KV-33-PRO/immo/src/costmap_converter/README.md

costmap_converter ROS Package
=============================

A ros package that includes plugins and nodes to convert occupied costmap2d cells to primitive types

Build status of the *master* branch:
- ROS Buildfarm Kinetic: Kinetic Build Status (http://build.ros.org/job/Kdev__costmap_converter__ubuntu_xenial_amd64/)
- ROS Buildfarm Indigo: Indigo Build Status (http://build.ros.org/job/Idev__costmap_converter__ubuntu_trusty_amd64/)

### Contributors

- Christoph Rösmann
- Franz Albers (*CostmapToDynamicObstacles* plugin)
- Otniel Rinaldo

### License

The *costmap_converter* package is licensed under the BSD license.
It depends on other ROS packages, which are listed in the package.xml. They are also BSD licensed.

Some third-party dependencies are included that are licensed under different terms:
 - *MultitargetTracker*, GNU GPLv3, https://github.com/Smorodov/Multitarget-tracker
   (partially required for the *CostmapToDynamicObstacles* plugin)

All packages included are distributed in the hope that they will be useful, but WITHOUT ANY WARRANTY; without even the implied warranty of MERCHANTABILITY or FITNESS FOR A PARTICULAR PURPOSE. See the licenses for more details.
