KV-33-PRO/immo/hardware/misc/README.txt

Дополнительная информация:
http://savageelectronics.blogspot.com/2011/08/actualizacion-biblioteca-dynamixel.html
http://hobbytech.com.ua/dynamixel-ax-12a-%D0%B8-arduino-%D0%BA%D0%B0%D0%BA-%D0%B8%D1%81%D0%BF%D0%BE%D0%BB%D1%8C%D0%B7%D0%BE%D0%B2%D0%B0%D1%82%D1%8C-%D0%BF%D0%BE%D1%8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
https://m.blog.naver.com/chandong83/221009668897
