KV-33-PRO/immo/hardware/src/modules_for_ROS/LedControl/README.txt

**********************************   README FILE   ***************************************

Contact: Kvantorium33

Version: Led_control library for ROS 01/01/2019

 Led_control Version 1.0.0

Requeriments:

Arduino IDE Version 1.0
Wiring IDE 0100

Installation:

Copy the files to your IDE libraries folder.

examples:

In the Program:
Copy "Led_control" folder to Arduino/Contents/Resources/Java/libraries. 

or

In the SketchBook:
Copy "Led_control" folder to Arduino/libraries.

ChangeLog:

 01/01/2019 - Create library.

 TODO:

******************************************************************************************
