KV-33-PRO/immo/hardware/misc/Battery_function.xlsx

analog | V
0 | 0 | 0
54 | 0.5 | 54
110 | 1 | 56
167 | 1.5 | 57
223 | 2 | 56
280 | 2.5 | 57
336 | 3 | 56
392 | 3.5 | 56
449 | 4 | 57
505 | 4.5 | 56
562 | 5 | 57
619 | 5.5 | 57
675 | 6 | 56
732 | 6.5 | 57
788 | 7 | 56
845 | 7.5 | 57
901 | 8 | 56
958 | 8.5 | 57
1014 | 9 | 56
1071 | 9.5 | 57
1129 | 10 | 58
1185 | 10.5 | 56
1242 | 11 | 57
1298 | 11.5 | 56
1356 | 12 | 58
1412 | 12.5 | 56
1468 | 13 | 56
1525 | 13.5 | 57
1583 | 14 | 58
1640 | 14.5 | 57
1697 | 15 | 57
26216 | 232.5 | 1697
873.8666667 | 7.75 | 56.56666667 | 113.1333333
 | 112.7569892
