KV-33-PRO/immo/src/graph_route/maps/map.png

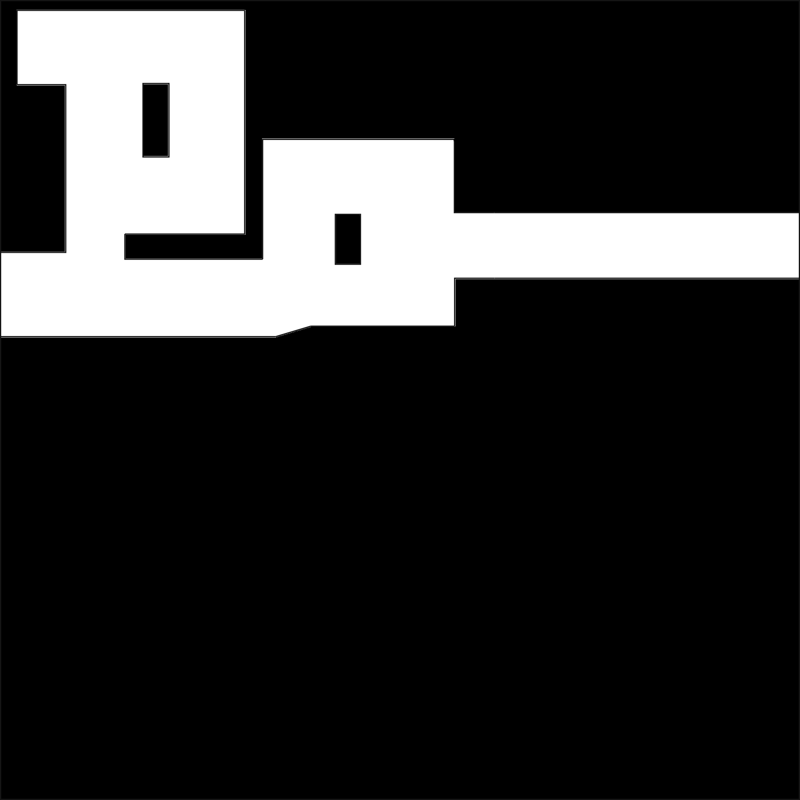
src/graph_route/maps/map.png
