KV-33-PRO/immo/src/graph_route/maps/profest.png

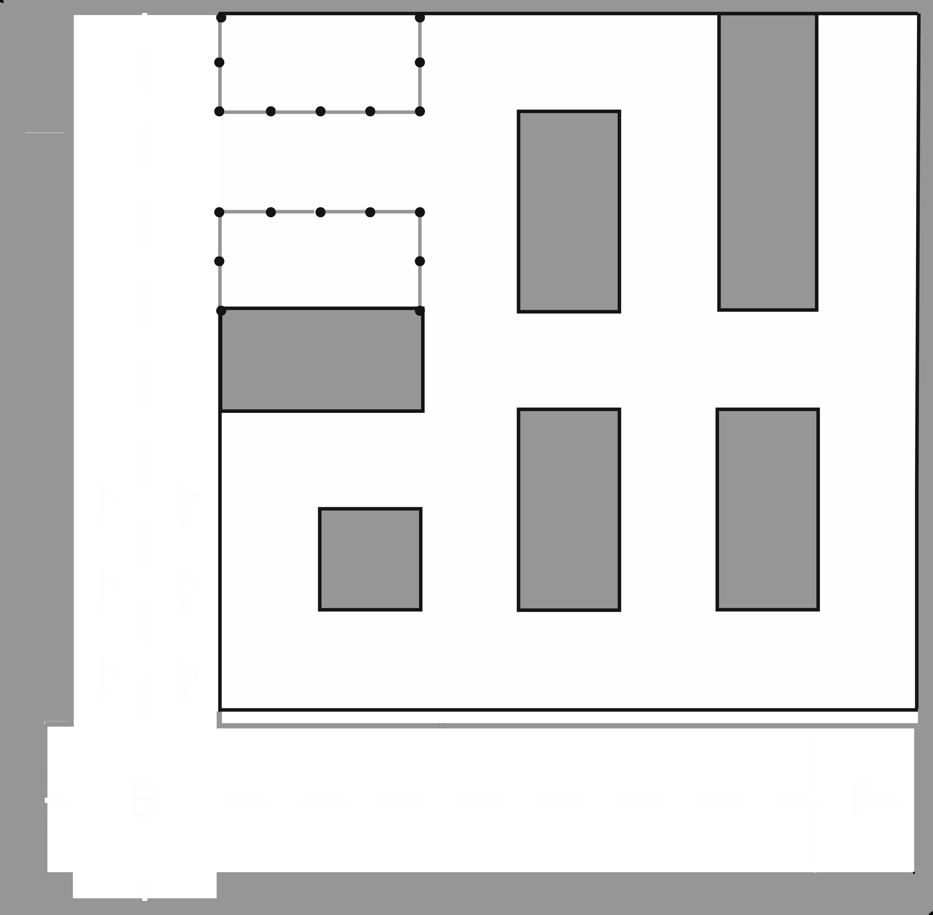
src/graph_route/maps/profest.png
