KV-33-PRO/immo/design/immo_design_project/Dynamixel AX-12/AX-12A.STEP

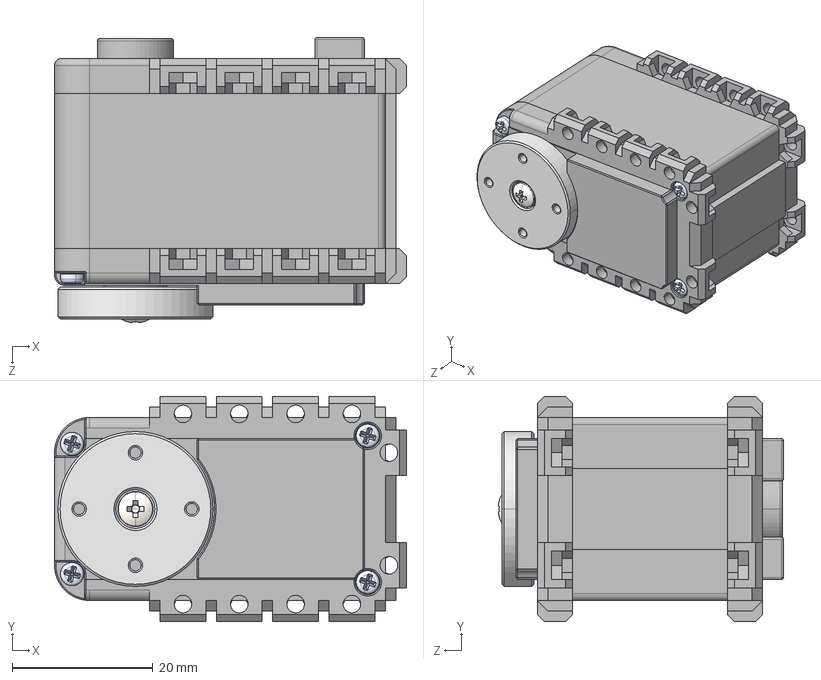
[picture p32: CAD file, 2018-12-13]
design/immo_design_project/Dynamixel AX-12/AX-12A.STEP
50.0 x 32.0 x 40.5 mm
AX-12A-01
AX-12A-02
AX-12A-03
AX-12A-04
SetScrew x 4
pan head cross recess screw_iso_ISO 7045 - M2.5 x 8 - Z --- 8C
