KV-33-PRO/immo/design/immo_design_project/В производство/06-01-Платформа для лидара.dxf

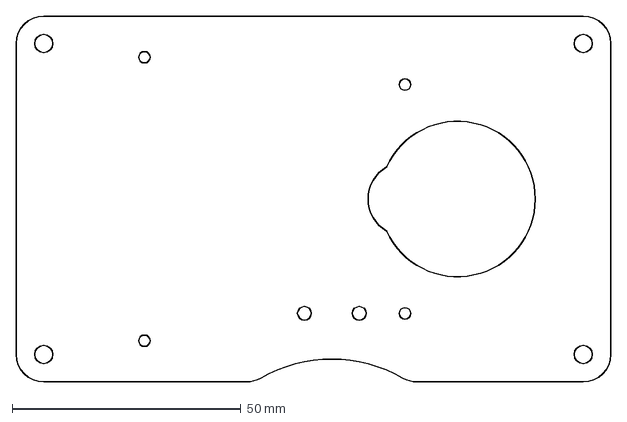
[picture p33: CAD file, 2018-12-15]
design/immo_design_project/В производство/06-01-Платформа для лидара.dxf
130.0 x 80.0 mm
