KV-33-PRO/immo/design/immo_design_project/В производство/04-01-Качалка.stl

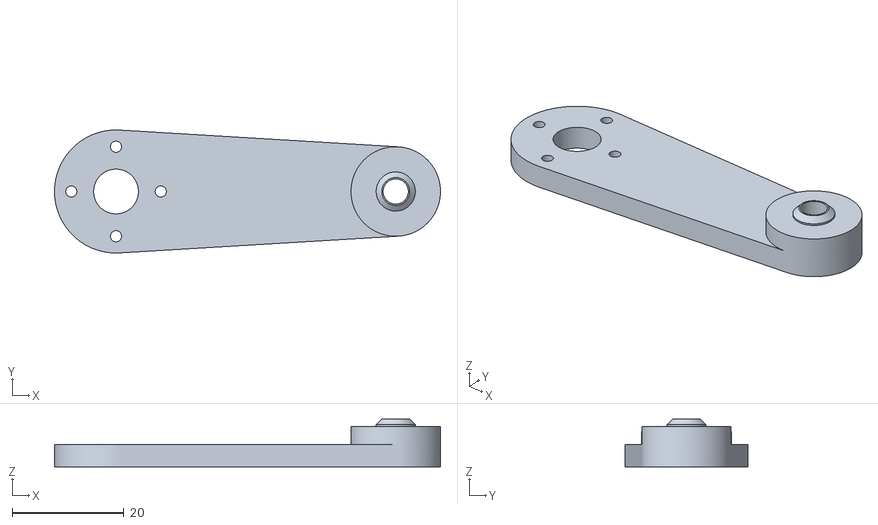
[picture p34: CAD file, 2018-12-13]
design/immo_design_project/В производство/04-01-Качалка.stl
69.0 x 22.0 x 8.55
