KV-33-PRO/immo/design/immo_design_project/В производство/05-01-Кронштейн низ защита.stl

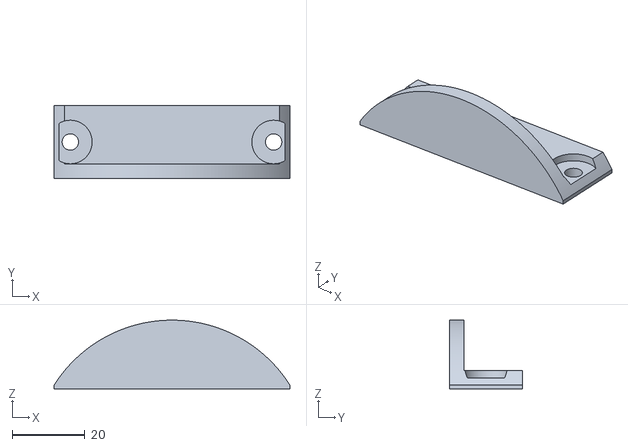
[picture p35: CAD file, 2018-12-13]
design/immo_design_project/В производство/05-01-Кронштейн низ защита.stl
65.0 x 20.0 x 18.9
