KV-33-PRO/immo/design/immo_design_project/В производство/05-01-Кронштейн верх.stl

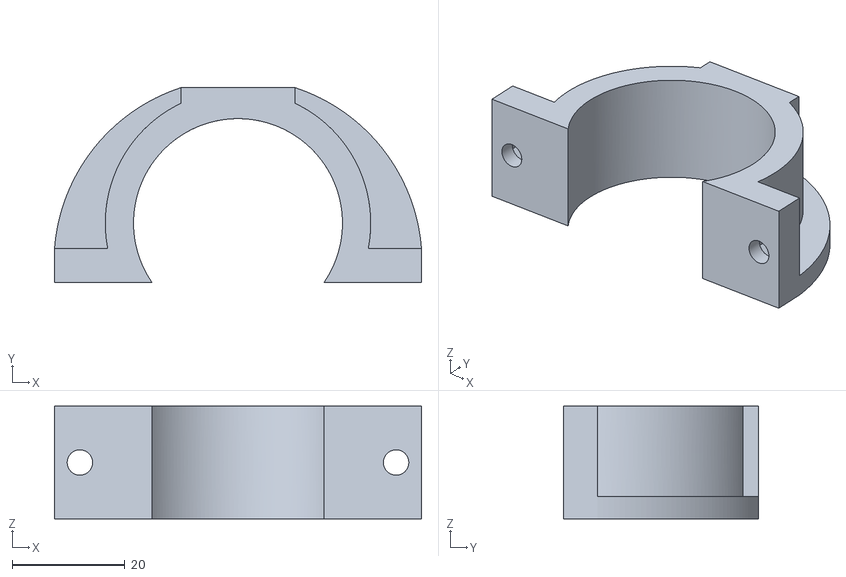
[picture p36: CAD file, 2018-12-13]
design/immo_design_project/В производство/05-01-Кронштейн верх.stl
65.0 x 34.5 x 20.0
