KV-33-PRO/immo/design/immo_design_project/В производство/04-08-Опора.stl

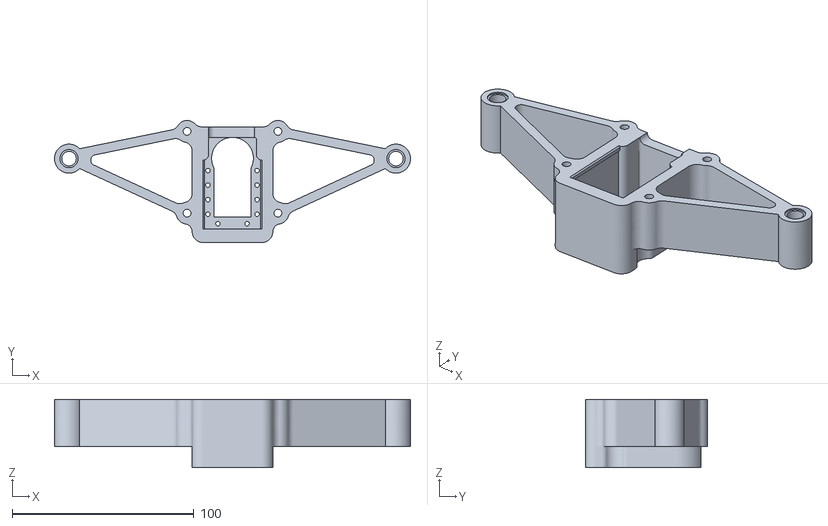
[picture p37: CAD file, 2018-12-13]
design/immo_design_project/В производство/04-08-Опора.stl
196.0 x 67.2 x 37.7
