KV-33-PRO/immo/design/immo_design_project/В производство/Ответная часть энкодера(колесо).stl

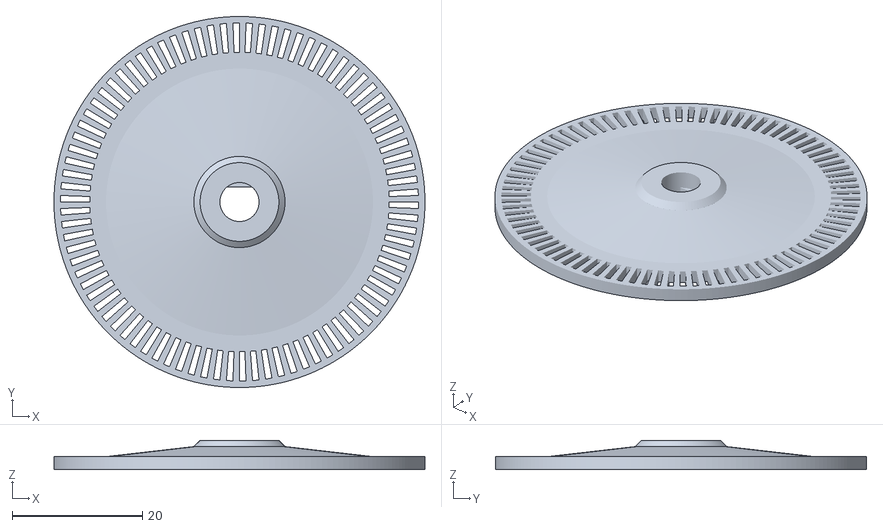
[picture p38: CAD file, 2018-12-13]
design/immo_design_project/В производство/Ответная часть энкодера(колесо).stl
57.0 x 57.0 x 4.50
