KV-33-PRO/immo/(list of files, cad)

Other CAD files:
design/immo_design_project/00-00-Сборка.iam
design/immo_design_project/00-01-Платформа.ipt
design/immo_design_project/01-00-Колесо.iam
design/immo_design_project/01-01-Шина.ipt
design/immo_design_project/01-02-Диск.ipt
design/immo_design_project/02-00-Двигатель.ipt
design/immo_design_project/03-00-Ступица.ipt
design/immo_design_project/04-00-Привод передний.iam
design/immo_design_project/04-01-Качалка.ipt
design/immo_design_project/04-02-Тяга.ipt
design/immo_design_project/04-03-Ось.ipt
design/immo_design_project/04-04-Кулак.ipt
design/immo_design_project/04-06-Рычаг.ipt
design/immo_design_project/04-07-Коромысло левое.ipt
design/immo_design_project/04-07-Коромысло правое.ipt
design/immo_design_project/04-08-Опора.ipt
design/immo_design_project/04-09-Подшипник 4х10.ipt
design/immo_design_project/05-01-Кронштейн верх.ipt
design/immo_design_project/05-01-Кронштейн низ защита.ipt
design/immo_design_project/05-01-Кронштейн низ.ipt
design/immo_design_project/05-01-Кронштейн.ipt
design/immo_design_project/05-01-Ответная часть энкодера(колесо).ipt
design/immo_design_project/06-01-Платформа для лидара (front).ipt
design/immo_design_project/06-01-Платформа для лидара (rear).ipt
design/immo_design_project/Dynamixel AX-12/AX-12A-01.ipt
design/immo_design_project/Dynamixel AX-12/AX-12A-02.ipt
design/immo_design_project/Dynamixel AX-12/AX-12A-03.ipt
design/immo_design_project/Dynamixel AX-12/AX-12A-04.ipt
design/immo_design_project/Dynamixel AX-12/AX-12A.iam
design/immo_design_project/Dynamixel AX-12/OldVersions/AX-12A-02.0001.ipt
design/immo_design_project/Dynamixel AX-12/OldVersions/AX-12A.0001.iam
design/immo_design_project/Dynamixel AX-12/SetScrew.ipt
design/immo_design_project/Dynamixel AX-12/pan head cross recess screw_iso_ISO 7045 - M2.5 x 8 - Z --- 8C.ipt
design/immo_design_project/Крепеж/OldVersions/Гайка М10.0001.ipt
design/immo_design_project/Крепеж/OldVersions/Гайка М6.0002.ipt
design/immo_design_project/Крепеж/Гайка М10.ipt
design/immo_design_project/Крепеж/Гайка М6.ipt
design/immo_design_project/Подшипники/OldVersions/Подшипник 4х8-Ю.0011.ipt
design/immo_design_project/Подшипники/OldVersions/Подшипник 4х8.0009.ipt
design/immo_design_project/Подшипники/OldVersions/Подшипник 6х19.0006.ipt
design/immo_design_project/Подшипники/Подшипник 4х10.ipt
design/immo_design_project/Подшипники/Подшипник 4х8-Ю.ipt
design/immo_design_project/Подшипники/Подшипник 4х8.ipt
design/immo_design_project/Подшипники/Подшипник 6х19.ipt
