KV-33-PRO/immo/design/immo_board/Driver/driver.brd

## EAGLE design design/immo_board/Driver/driver.brd (2019-01-31)

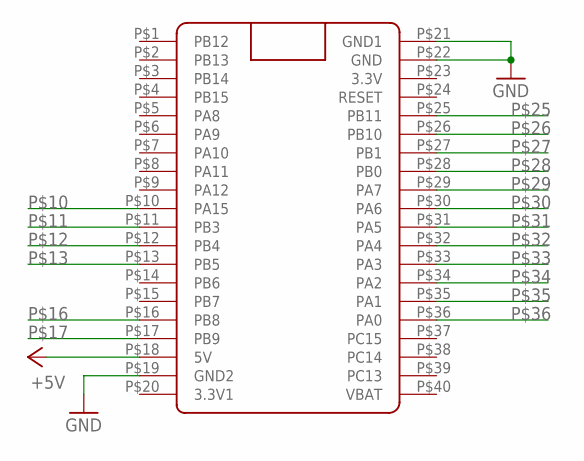
[picture p39: schematic driver.sch, sheet 1, Arduino STM32F103C8T6]

Parts:
U$1: STM32F103C8T6; BLUE_PILL_ADV

Connections:
+5V: U$1.P$18 (5V); also elsewhere on the board
GND: U$1.P$19 (GND2), U$1.P$21 (GND1), U$1.P$22 (GND); also elsewhere on the board
P$10: U$1.P$10 (PA15); also elsewhere on the board
P$11: U$1.P$11 (PB3); also elsewhere on the board
P$12: U$1.P$12 (PB4); also elsewhere on the board
P$13: U$1.P$13 (PB5); also elsewhere on the board
P$16: U$1.P$16 (PB8); also elsewhere on the board
P$17: U$1.P$17 (PB9); also elsewhere on the board
P$25: U$1.P$25 (PB11); also elsewhere on the board
P$26: U$1.P$26 (PB10); also elsewhere on the board
P$27: U$1.P$27 (PB1); also elsewhere on the board
P$28: U$1.P$28 (PB0); also elsewhere on the board
P$29: U$1.P$29 (PA7); also elsewhere on the board
P$30: U$1.P$30 (PA6); also elsewhere on the board
P$31: U$1.P$31 (PA5); also elsewhere on the board
P$32: U$1.P$32 (PA4); also elsewhere on the board
P$33: U$1.P$33 (PA3); also elsewhere on the board
P$34: U$1.P$34 (PA2); also elsewhere on the board
P$35: U$1.P$35 (PA1); also elsewhere on the board
P$36: U$1.P$36 (PA0); also elsewhere on the board

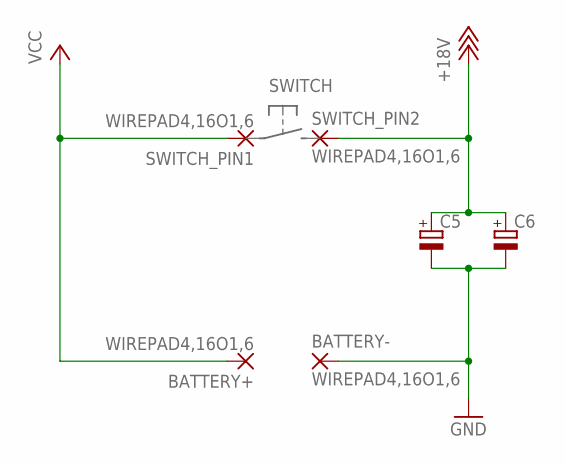
[picture p40: schematic driver.sch, sheet 2, Разъем для аккумулятора, выключатель и перемычки на землю]

Parts:
BATTERY+: WIREPAD4,16O1,6; 4,16O1,6
BATTERY-: WIREPAD4,16O1,6; 4,16O1,6
C5: CPOL-EUE5-8.5; E5-8,5
C6: CPOL-EUE2.5-5; E2,5-5
SWITCH_PIN1, SWITCH_PIN2: WIREPAD4,16O1,6; 4,16O1,6

Connections:
+18V: C5.+, C6.+, SWITCH_PIN2.1; also elsewhere on the board
GND: BATTERY-.1, C5.-, C6.-; also elsewhere on the board
VCC: BATTERY+.1, SWITCH_PIN1.1

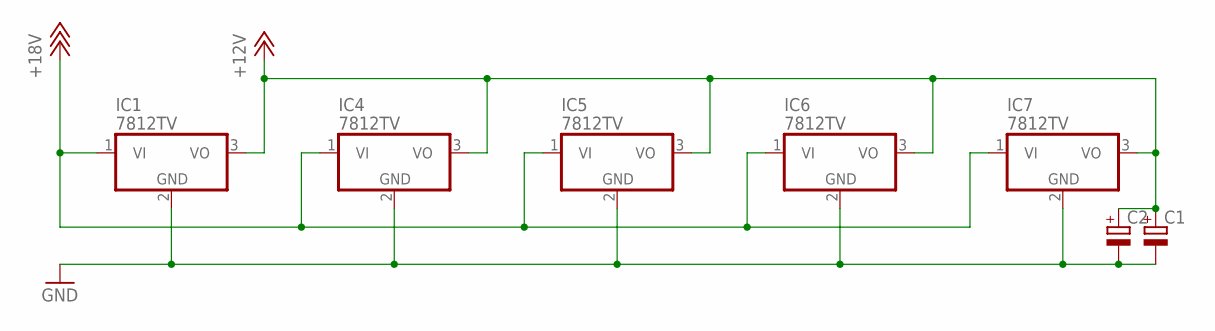
[picture p41: schematic driver.sch, sheet 3, Линия питания 12V]

Parts:
C1: CPOL-EUE5-8.5; E5-8,5
C2: CPOL-EUE2.5-5; E2,5-5
IC1, IC4, IC5, IC6, IC7: 7812TV; TO220V

Connections:
+12V: C1.+, C2.+, IC1.3 (VO), IC4.3 (VO), IC5.3 (VO), IC6.3 (VO), IC7.3 (VO); also elsewhere on the board
+18V: IC1.1 (VI), IC4.1 (VI), IC5.1 (VI), IC6.1 (VI), IC7.1 (VI); also elsewhere on the board
GND: C1.-, C2.-, IC1.2 (GND), IC4.2 (GND), IC5.2 (GND), IC6.2 (GND), IC7.2 (GND); also elsewhere on the board

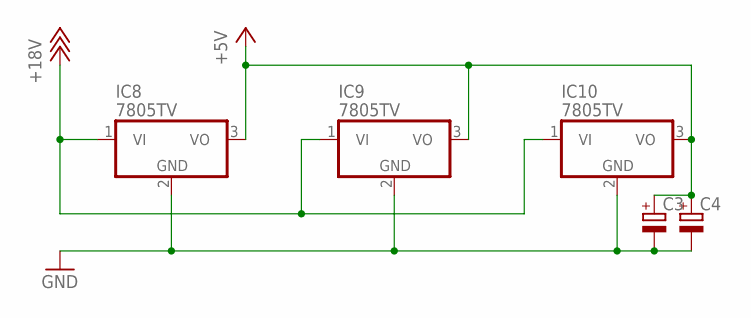
[picture p42: schematic driver.sch, sheet 4, Линия питания 5V]

Parts:
C3: CPOL-EUE2.5-5; E2,5-5
C4: CPOL-EUE5-8.5; E5-8,5
IC8, IC9, IC10: 7805TV; TO220V

Connections:
+5V: C3.+, C4.+, IC8.3 (VO), IC9.3 (VO), IC10.3 (VO); also elsewhere on the board
+18V: IC8.1 (VI), IC9.1 (VI), IC10.1 (VI); also elsewhere on the board
GND: C3.-, C4.-, IC8.2 (GND), IC9.2 (GND), IC10.2 (GND); also elsewhere on the board

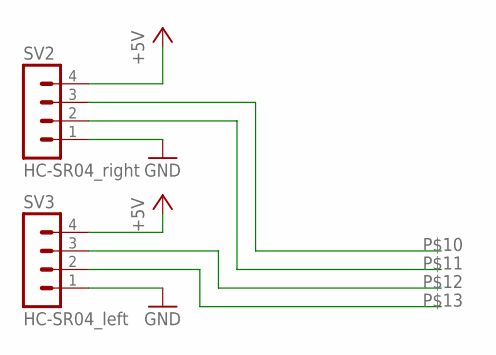
[picture p43: schematic driver.sch, sheet 5, Ультразвуковые датчики]

Parts:
SV2: HC-SR04_right; MA04-1
SV3: HC-SR04_left; MA04-1

Connections:
+5V: SV2.4, SV3.4; also elsewhere on the board
GND: SV2.1, SV3.1; also elsewhere on the board
P$10: SV2.3; also elsewhere on the board
P$11: SV2.2; also elsewhere on the board
P$12: SV3.3; also elsewhere on the board
P$13: SV3.2; also elsewhere on the board

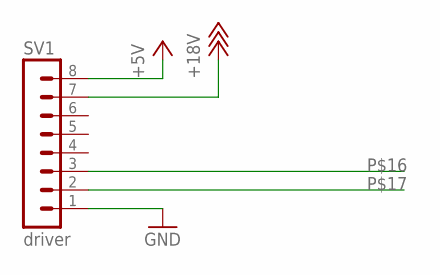
[picture p44: schematic driver.sch, sheet 6, Драйвер электромоторов]

Parts:
SV1: driver; MA08-1

Connections:
+5V: SV1.8; also elsewhere on the board
+18V: SV1.7; also elsewhere on the board
GND: SV1.1; also elsewhere on the board
P$16: SV1.3; also elsewhere on the board
P$17: SV1.2; also elsewhere on the board

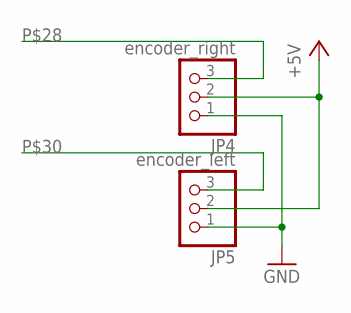
[picture p45: schematic driver.sch, sheet 7, Датчики числа оборотов колес]

Parts:
JP4: encoder_right; 1X03
JP5: encoder_left; 1X03

Connections:
+5V: JP4.2, JP5.2; also elsewhere on the board
GND: JP4.1, JP5.1; also elsewhere on the board
P$28: JP4.3; also elsewhere on the board
P$30: JP5.3; also elsewhere on the board

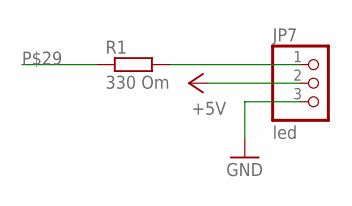
[picture p46: schematic driver.sch, sheet 8, Световая индикация]

Parts:
JP7: led; 1X03
R1: 330 Om; 0207/12

Connections:
+5V: JP7.2; also elsewhere on the board
GND: JP7.3; also elsewhere on the board
unnamed: JP7.1, R1.2
P$29: R1.1; also elsewhere on the board

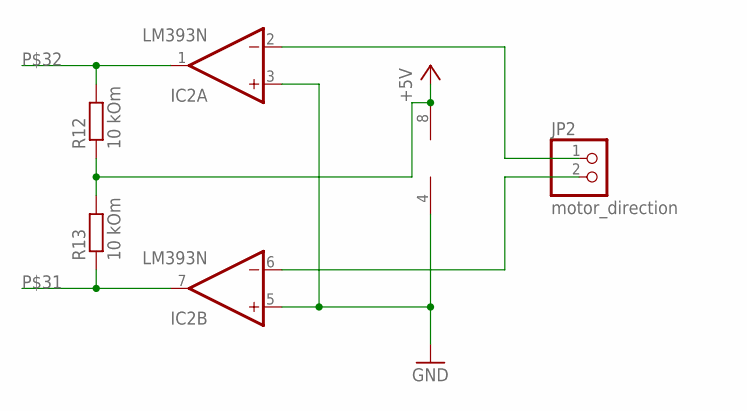
[picture p47: schematic driver.sch, sheet 9, Датчик направления движения]

Parts:
IC2: LM393N; DIL08
JP2: motor_direction; 1X02
R12, R13: 10 kOm; 0207/12

Connections:
+5V: IC2.8 (V+), R12.1, R13.2; also elsewhere on the board
GND: IC2.3 (+IN), IC2.4 (V-), IC2.5 (+IN); also elsewhere on the board
unnamed: IC2.2 (-IN), JP2.1
unnamed: IC2.6 (-IN), JP2.2
P$31: IC2.7 (OUT), R13.1; also elsewhere on the board
P$32: IC2.1 (OUT), R12.2; also elsewhere on the board

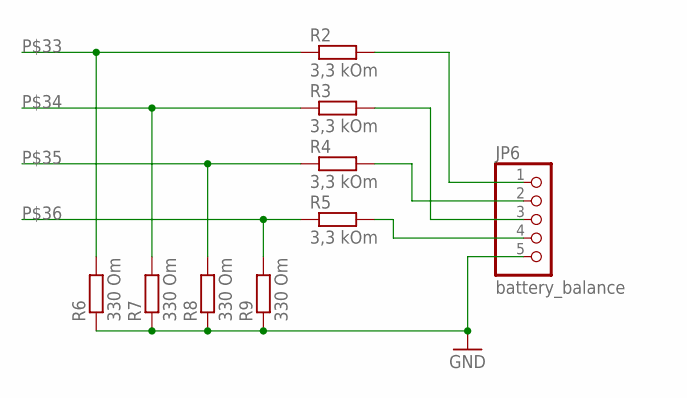
[picture p48: schematic driver.sch, sheet 10, Датчик напряжения аккумулятора]

Parts:
JP6: battery_balance; 1_05X2MM
R2, R3, R4, R5: 3,3 kOm; 0207/15
R6, R7, R8, R9: 330 Om; 0207/15

Connections:
GND: JP6.5, R6.1, R7.1, R8.1, R9.1; also elsewhere on the board
unnamed: JP6.4, R5.2
unnamed: JP6.2, R4.2
unnamed: JP6.3, R3.2
unnamed: JP6.1, R2.2
P$33: R2.1, R6.2; also elsewhere on the board
P$34: R3.1, R7.2; also elsewhere on the board
P$35: R4.1, R8.2; also elsewhere on the board
P$36: R5.1, R9.2; also elsewhere on the board

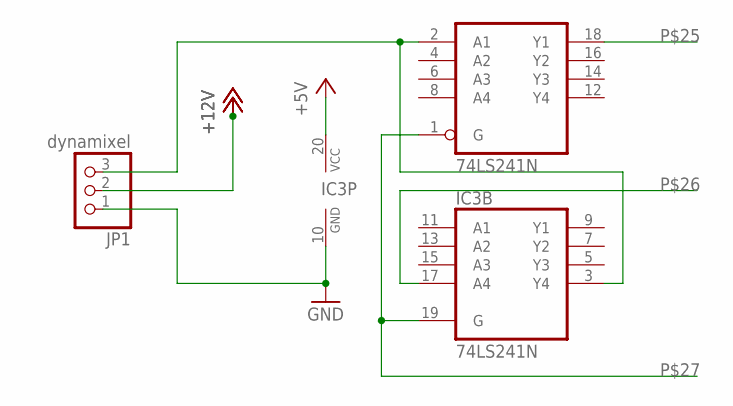
[picture p49: schematic driver.sch, sheet 11, Рулевое управление]

Parts:
IC3: 74LS241N; DIL20
JP1: dynamixel; 1X03

Connections:
+5V: IC3.20 (VCC); also elsewhere on the board
+12V: JP1.2; also elsewhere on the board
GND: IC3.10 (GND), JP1.1; also elsewhere on the board
unnamed: IC3.2 (A1), IC3.3 (Y4), JP1.3
P$25: IC3.18 (Y1); also elsewhere on the board
P$26: IC3.17 (A4); also elsewhere on the board
P$27: IC3.1 (G), IC3.19 (G); also elsewhere on the board

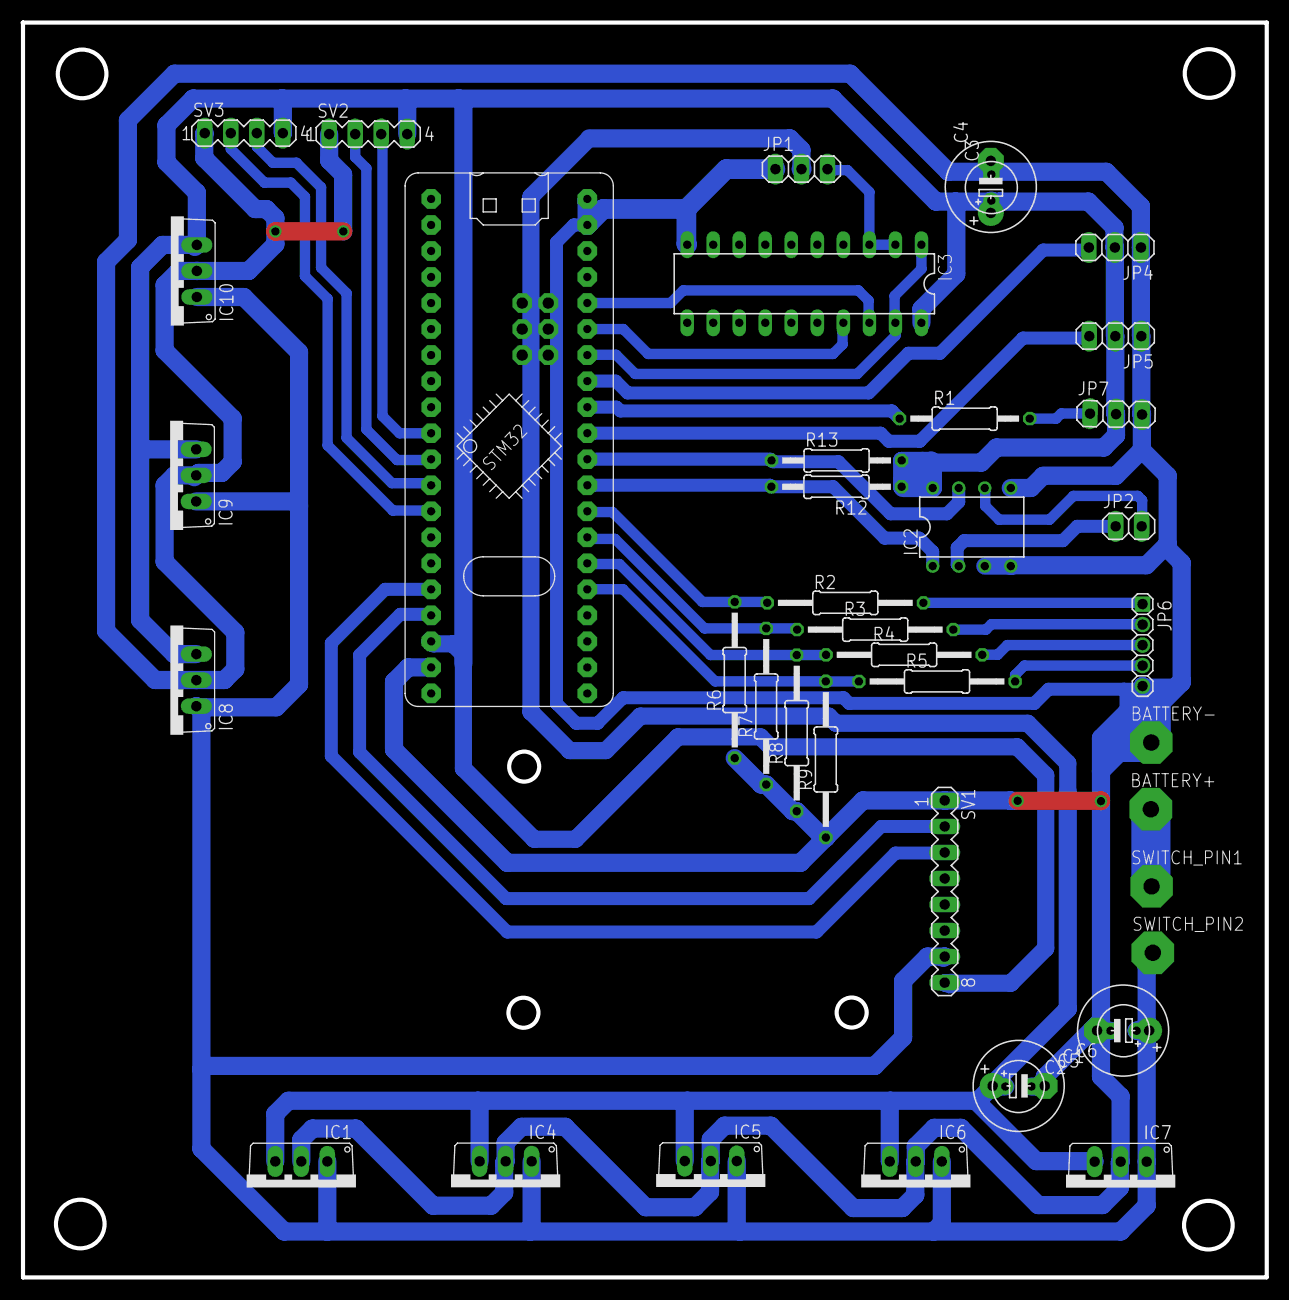
[picture p50: board driver.brd from above]

Board: 2 copper layers, 121.4 x 122.5 mm, 41 parts (0 on the bottom side), 31 nets.
