KV-33-PRO/immo/design/immo_board/WS2812B/ws2812B.brd

## EAGLE design design/immo_board/WS2812B/ws2812B.brd (2019-01-31)

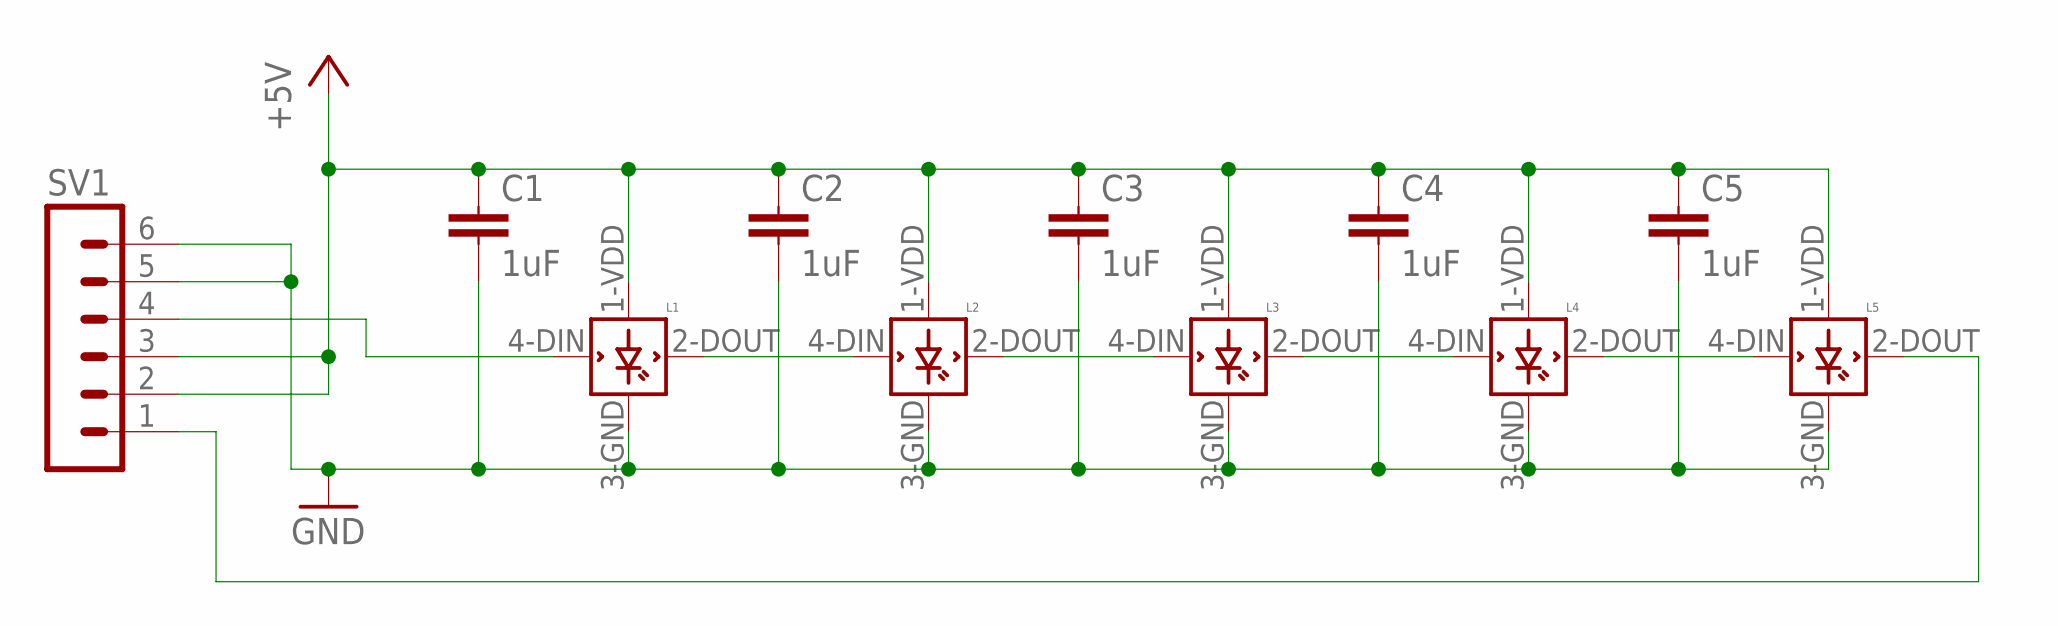
[picture p51: schematic ws2812B.sch]

Parts:
C1, C2, C3, C4, C5: 1uF; C10B4
L1, L2, L3, L4, L5: WS2812B
SV1: MA06-1

Connections:
+5V: C1.1, C2.1, C3.1, C4.1, C5.1, L1.1-VDD (VDD), L2.1-VDD (VDD), L3.1-VDD (VDD), L4.1-VDD (VDD), L5.1-VDD (VDD), SV1.2, SV1.3
GND: C1.2, C2.2, C3.2, C4.2, C5.2, L1.3-GND (GND), L2.3-GND (GND), L3.3-GND (GND), L4.3-GND (GND), L5.3-GND (GND), SV1.5, SV1.6
unnamed: L1.4-DIN (DIN), SV1.4
unnamed: L4.2-DOUT (DOUT), L5.4-DIN (DIN)
unnamed: L5.2-DOUT (DOUT), SV1.1
unnamed: L1.2-DOUT (DOUT), L2.4-DIN (DIN)
unnamed: L2.2-DOUT (DOUT), L3.4-DIN (DIN)
unnamed: L3.2-DOUT (DOUT), L4.4-DIN (DIN)

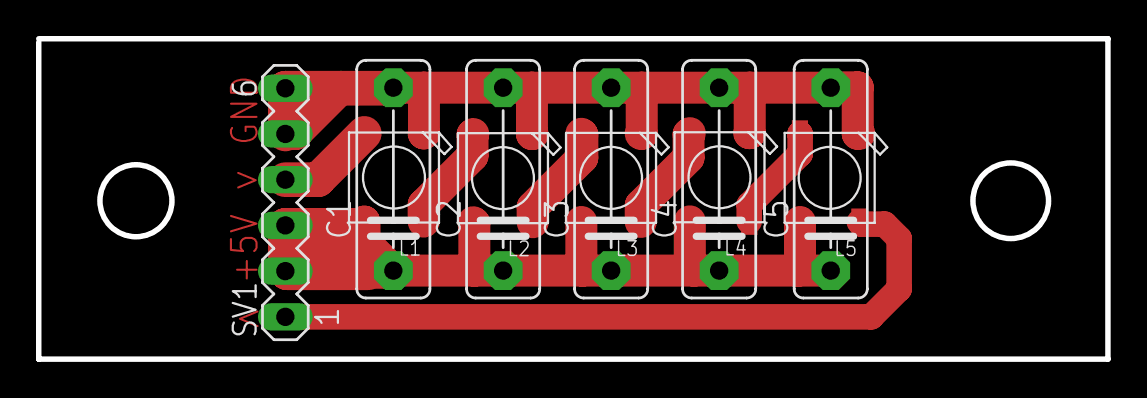
[picture p52: board ws2812B.brd from above]

Board: 2 copper layers, 59.4 x 17.8 mm, 11 parts (0 on the bottom side), 8 nets.
