KV-33-PRO/immo/design/immo_board/Encoder/Encoder_board.brd

## EAGLE design design/immo_board/Encoder/Encoder_board.brd (2019-01-31)

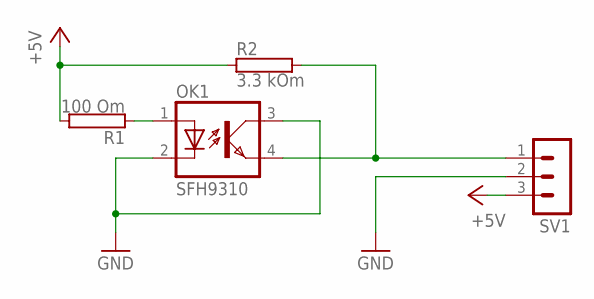
[picture p53: schematic Encoder_board.sch]

Parts:
OK1: SFH9310
R1: 100 Om; RS1/4
R2: 3.3 kOm; RS1/4
SV1: MA03-1

Connections:
+5V: R1.2, R2.1, SV1.3
GND: OK1.2 (C), OK1.3 (COL), SV1.2
unnamed: OK1.1 (A), R1.1
SIG: OK1.4 (EMIT), R2.2, SV1.1

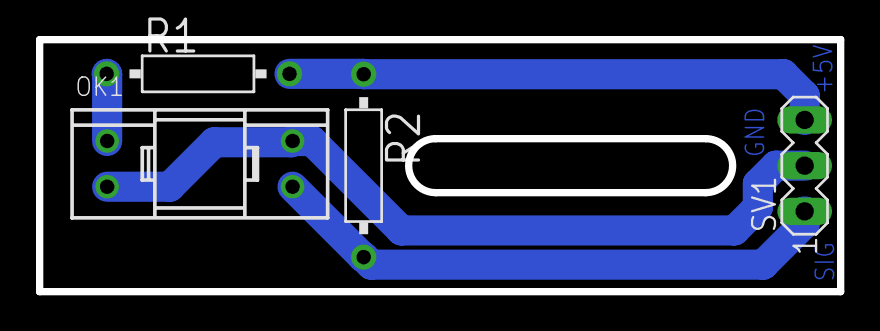
[picture p54: board Encoder_board.brd from above]

Board: 2 copper layers, 44.5 x 14.0 mm, 4 parts (0 on the bottom side), 4 nets.
