KV-33-PRO/immo/src/graph_route/config/graph_profest3.yaml

max_covariance: 0.2
finish: 86

node0:
    x: 16.6
    y: 17

node1:
    x: 16.6
    y: 13

node2:
    x: 16.6
    y: 12

node3:
    x: 16
    y: 11.6

node4:
    x: 16.6
    y: 10

node5:
    x: 16.6
    y: 6

node6:
    x: 16
    y: 5.6

node7:
    x: 15
    y: 5.6

node8:
    x: 14
    y: 5.6

node9:
    x: 13.4
    y: 6

node10:
    x: 12
    y: 5.6

node11:
    x: 11
    y: 5.6

node12:
    x: 10
    y: 5.6

node13:
    x: 9.4
    y: 6

node14:
    x: 8
    y: 5.6

node15:
    x: 7
    y: 5.6

node16:
    x: 6
    y: 5.6

node17:
    x: 5.4
    y: 6

node18:
    x: 5.4
    y: 7

node19:
    x: 5.4
    y: 8

node20:
    x: 6
    y: 8.6

node21:
    x: 7
    y: 8.6

node22:
    x: 8
    y: 8.6

node23:
    x: 8.6
    y: 8

node24:
    x: 8.6
    y: 7

node25:
    x: 8.6
    y: 6

node26:
    x: 9.4
    y: 10

node27:
    x: 10
    y: 10.6

node28:
    x: 11
    y: 10.6

node29:
    x: 12
    y: 10.6

node30:
    x: 12.6
    y: 10

node31:
    x: 12.6
    y: 7

node32:
    x: 12.6
    y: 6

node33:
    x: 9.4
    y: 9

node34:
    x: 13.4
    y: 10

node35:
    x: 13.4
    y: 9

node36:
    x: 14
    y: 10.6

node37:
    x: 15
    y: 10.6

node38:
    x: 16
    y: 10.6

node39:
    x: 16.6
    y: 7

node40:
    x: 15
    y: 11.6

node41:
    x: 14
    y: 11.6

node42:
    x: 13.4
    y: 12

node43:
    x: 12
    y: 11.6

node44:
    x: 11
    y: 11.6

node45:
    x: 4
    y: 15

node46:
    x: 10
    y: 11.6

node47:
    x: 9.4
    y: 12

node48:
    x: 9.4
    y: 14

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
  enabled: 1

link18_19:
  enabled: 1

link19_20:
  enabled: 1

link20_21:
  enabled: 1

link21_22:
  enabled: 1

link22_23:
  enabled: 1

link41_43:
  enabled: 1

link29_36:
  enabled: 1

link29_42:
  enabled: 1

link41_30:
  enabled: 1

link22_26:
  enabled: 1

link73_13:
  enabled: 1
