KV-33-PRO/immo/hardware/src/modules_for_ROS/LedControl/LedControl.cpp

#if defined(ARDUINO) && ARDUINO >= 100  // Arduino IDE Version
#include "Arduino.h"
#else
#include <WProgram.h>
#endif

#include "LedControl.h"

//TOPICS
#define HEAD     0
#define TURN     1
#define BACK     2
#define BRAKE    3
#define FLASHER  4
#define POSITION 5


//STATUS MSGS

//TURN
#define TURN_OFF   0
#define TURN_LEFT  1
#define TURN_RIGHT 2
#define TURN_FLASH 3

//HEAD
#define HEAD_OFF         0
#define HEAD_DIPPED_BEAM 1
#define HEAD_HIGH_BEAM   2

//BACK
#define BACK_OFF 0
#define BACK_ON  1

//BRAKE
#define BRAKE_OFF 0
#define BRAKE_ON  1

//FLASHER
#define FLASHER_OFF 0
#define FLASHER_ON  1

//POSITION_LAMPS
#define POSITION_LAMPS_OFF 0
#define POSITION_LAMPS_ON  1


//INDICATION STATUS
#define POSITION_LAMPS     0
#define DIPPED_BEAM_LAMPS  1
#define HIGH_BEAM_LAMPS    2
#define BRAKE_LAMPS        3
#define BACK_LAMPS         4
#define TURN_LEFT_LAMPS    5
#define TURN_RIGHT_LAMPS   6
#define FLASHER_LAMPS      7

// Private Methods //////////////////////////////////////////////////////////////

void LedControl::head_cb(const std_msgs::UInt8& mode) {
    _indication[HEAD][0]=mode;
    if(statusChanged(HEAD)){
        switch (_indication[HEAD][0].data) {
        case HEAD_OFF:
            _indication_status[DIPPED_BEAM_LAMPS]=false;
            _indication_status[HIGH_BEAM_LAMPS]=false;
            break;
        case HEAD_DIPPED_BEAM:
            _indication_status[DIPPED_BEAM_LAMPS]=true;
            _indication_status[HIGH_BEAM_LAMPS]=false;
            break;
        case HEAD_HIGH_BEAM:
            _indication_status[DIPPED_BEAM_LAMPS]=false;
            _indication_status[HIGH_BEAM_LAMPS]=true;
            break;
        default:
            break;
        }
    }
}

void LedControl::turn_cb(const std_msgs::UInt8& mode) {
    _indication[TURN][0]=mode;
    if(statusChanged(TURN)){
        switch (_indication[TURN][0].data) {
        case TURN_OFF:
            _indication_status[TURN_LEFT_LAMPS]=false;
            _indication_status[TURN_RIGHT_LAMPS]=false;
            break;
        case TURN_LEFT:
            _indication_status[TURN_LEFT_LAMPS]=true;
            _indication_status[TURN_RIGHT_LAMPS]=false;
            break;
        case TURN_RIGHT:
            _indication_status[TURN_LEFT_LAMPS]=false;
            _indication_status[TURN_RIGHT_LAMPS]=true;
            break;
        case TURN_FLASH:
            _indication_status[TURN_LEFT_LAMPS]=true;
            _indication_status[TURN_RIGHT_LAMPS]=true;
            break;
        default:
            break;
        }
    }
}

void LedControl::back_cb(const std_msgs::UInt8& mode) {
    _indication[BACK][0]=mode;
    if(statusChanged(BACK)){
        switch (_indication[BACK][0].data) {
        case BACK_OFF:
             _indication_status[BACK_LAMPS]=false;
            break;
        case BACK_ON:
             _indication_status[BACK_LAMPS]=true;
            break;
        default:
            break;
        }
    }
}

void LedControl::brake_cb(const std_msgs::UInt8& mode) {
    _indication[BRAKE][0]=mode;
    if(statusChanged(BRAKE)){
        switch (_indication[BRAKE][0].data) {
        case BRAKE_OFF:
            _indication_status[BRAKE_LAMPS]=false;
            break;
        case BRAKE_ON:
            _indication_status[BRAKE_LAMPS]=true;
            break;
        default:
            break;
        }
    }
}

void LedControl::flasher_cb(const std_msgs::UInt8& mode) {
    _indication[FLASHER][0]=mode;
    if(statusChanged(FLASHER)){
        switch (_indication[FLASHER][0].data) {
        case FLASHER_OFF:
            _indication_status[FLASHER_LAMPS]=false;
            break;
        case FLASHER_ON:
            _indication_status[FLASHER_LAMPS]=true;
            break;
        default:
            break;
        }
    }
}

void LedControl::position_cb(const std_msgs::UInt8& mode) {
    _indication[POSITION][0]=mode;
    if(statusChanged(POSITION)){
        switch (_indication[POSITION][0].data) {
        case POSITION_LAMPS_OFF:
            _indication_status[POSITION_LAMPS]=false;
            break;
        case POSITION_LAMPS_ON:
            _indication_status[POSITION_LAMPS]=true;
            break;
        default:
            break;
        }
    }
}

bool LedControl::statusChanged(int strIndication){
    if(_indication[strIndication][0].data!=_indication[strIndication][1].data)
    {
        _indication[strIndication][1]=_indication[strIndication][0];
        return true;
    }
    else
    {
        return false;
    }
}

// Public Methods //////////////////////////////////////////////////////////////

LedControl::LedControl() :
    _head_sub("light_control/head", &LedControl::head_cb, this),
    _turn_sub("light_control/turn", &LedControl::turn_cb, this),
    _back_sub("light_control/back", &LedControl::back_cb, this),
    _brake_sub("light_control/brake", &LedControl::brake_cb, this),
    _flasher_sub("light_control/flasher", &LedControl::flasher_cb, this),
    _position_sub("light_control/position", &LedControl::position_cb, this)
{
    for(int i=0; i<COUNT_INDICATION_STATUS; i++)
    {
        _indication_status[i]=false;
    }
}

void LedControl::init(ros::NodeHandle &nh) {
    _nh = &nh;
    _nh->subscribe(_head_sub);
    _nh->subscribe(_turn_sub);
    _nh->subscribe(_back_sub);
    _nh->subscribe(_brake_sub);
    _nh->subscribe(_flasher_sub);
    _nh->subscribe(_position_sub);
    Led.init();
}

void LedControl::indication(){
    Led.indication(_indication_status);
}
