KV-33-PRO/immo/(commit log)

2018-12-01 Fix driver.ino. Add futs_qt_odometry.
    [driver.ino]
2018-12-02 Rename "futs_qt_odometry" to "odometry". Fix odometry algorithms.
2018-12-03 Add odometry.launch. Fix odometry.
    [driver.ino]
2018-12-04 Fix odometry algorithms
2018-12-05 Update sensors MCU firmware
    Sensors configuration and measuring formula are updated
2018-12-06 Update sensors MCU firmware
2018-12-06 Sensors MCU firmware
    Ultrasonic rangefinder now works
2018-12-06 (Sensors MCU)fix baud
2018-12-07 Fix driver algorithm. Add support dynamixel. Add libraries for arduino.
    [driver.ino]
2018-12-13 Add design project
    [00-00-Сборка.iam, 00-01-Платформа.ipt, 01-00-Колесо.iam, 01-01-Шина.ipt, 01-02-Диск.ipt, 02-00-Двигатель.ipt, 03-00-Ступица.ipt, 04-00-Привод передний.iam]
2018-12-13 Fix include libraries. Add ros_lib for STM32 and DynamixelSerial3.
2018-12-14 Fix driver firmware (for STM32). Add picture pinout STM32F103C8T6.
    [driver.ino]
2018-12-14 Fix driver firmware. Add comments for driver firmware. Add directory misc.
    [driver.ino]
2018-12-15 Add immo_board for encoders. Rename IMMO to immo_design_project.
    [00-00-Сборка.iam, 00-01-Платформа.ipt, 01-00-Колесо.iam, 01-01-Шина.ipt, 01-02-Диск.ipt, 02-00-Двигатель.ipt, 03-00-Ступица.ipt, 04-00-Привод передний.iam]
2018-12-17 Fix algorithm odometry (direction of travel). Fix port to driver.launch.
    [driver.ino]
2018-12-19 Add module for battery. Move driver, sensors to "src"
2018-12-21 Fix battery (function trend line). Add results experiment.
    [Battery_function.xlsx]
2018-12-21 Add PID regulator for speed control motors.
2018-12-22 Add driver_move package for tests. Add battery_module in driver hardware.
    [Battery_function.xlsx]
2018-12-23 Fix alghoritm driver odometry and driver_move.
    [driver.ino]
2018-12-24 Fix firmware sensors (stm32). Add library Ultrasonic. Delete library NewPing.
    [sensors.ino]
2018-12-25 Add library SimpleKalmanFilter. Fix sensors (add kalman filter for sonars).
    [sensors.ino]
2018-12-26 Add board and scheme for WS2812B. Move Encoder_board.brd to immo_board/ Encoder.
    [Encoder_board.brd, ws2812B.brd, ws2812B.sch]
2018-12-26 Add library for WS2812B leds. Add firmware led indication.
2018-12-27 Fix led firmware.
2018-12-29 Add electric scheme for driver board.
    [driver.brd, driver.sch]
2018-12-30 Add board for driver. Fix electric scheme.
    [driver.brd, driver.sch]
2019-01-16 Fix board for driver. Fix electric scheme.
    [driver.brd, driver.sch]
2019-01-16 Fix driver firmware (pins). Fix led firmware.
    [driver.ino]
2019-01-17 Fix driver firmware.
2019-01-17 Fix driver_move. Add param in launch.
2019-01-17 Fix launch driver (add start odometry). Fix launch odometry (respawn).
2019-01-31 Fix board and electrical scheme for Encoder, Driver, WS2812B.
    [Encoder_board.brd, Encoder_board.sch, driver.brd, driver.sch, ws2812B.brd, ws2812B.sch]
2019-01-31 Fix tf in odometry_node.cpp
2019-01-31 Fix board and electric scheme. Add capacitors.
    [Encoder_board.brd, Encoder_board.sch, driver.brd, driver.sch, ws2812B.brd, ws2812B.sch]
2019-01-31 Fix driver scheme (supply switch)
    [driver.brd, driver.sch]
2019-02-07 Add instruction install STM32 in Arduino IDE.
2019-02-07 Fix Battery module for ROS, add Battery lib in driver. Add method angular2dynamixel for odometry.
    [Battery.cpp, Battery.h, Battery.ino, driver.ino]
2019-02-09 Add led_control_node and led_control.launch. Fix Battery library (example). Add Sensor_sonar library for ROS.
    [Battery.ino, Sensor_sonar.ino, led_control_node.cpp]
2019-02-11 Fix Sensor_sonar. Remove sensors.ino. Fix led_control_node.cpp. Add Led and Led_control library in modules_for_ROS.
    [Led.ino, Led_control.cpp, Led_control.ino, led_control_node.cpp, sensors.ino]
2019-02-12 Rename Led_control to LedControl. Fix code LedControl.
    [LedControl.cpp, LedControl.h, LedControl.ino]
2019-02-12 Add teleop_keyboard for move control. Add launch: teleop.launch and GO.launch (for start all nodes). Fix driver.launch.
2019-02-12 Update code in LedControl. Fix GO.launch. Remove launch sensors.
    [LedControl.cpp, LedControl.h, LedControl.ino]
2019-02-13 Fix Led library.
2019-02-19 Fix LedControl library, teleop_key node. Add setup_config.
    [LedControl.cpp, LedControl.h, LedControl.ino]
2019-02-20 Fix engine control in the absence of communication.
    [driver.ino]
2019-02-21 Add setup_autostart ROS. Add immo.launch for autostart nodes. Fix Led library. Delete GO.launch.
    [Led.ino]
2019-02-22 Rename library Led to LedWS2812BforSTM32. Fix in LedWS2812BforSTM32. Fix in LedControl.
    [LedControl.cpp, LedControl.h, LedWS2812BforSTM32.cpp, LedWS2812BforSTM32.h, LedWS2812BforSTM32.ino]
2019-02-23 Fix LEDS library.
2019-02-23 Fix led indication. Add viu viu tr tr. Delete led.ino.
    [LedWS2812BforSTM32.cpp, LedWS2812BforSTM32.h, LedWS2812BforSTM32.ino, led_control_node.cpp]
2019-02-25 Optimization LedWS2812BforSTM32. Fix launch files. Fix rviz config.
    [LedWS2812BforSTM32.cpp, LedWS2812BforSTM32.h]
2019-02-26 Fix viu viu tr tr algorithm. Fix turn signal algorithm.
    [LedWS2812BforSTM32.cpp, LedWS2812BforSTM32.h]
2019-03-02 Add navigation. Fix driver. Fix led_control. Fix hls_lfcd_lds.
    [AMCL.cfg, BaseLocalPlanner.cfg, DWAPlanner.cfg, GlobalPlanner.cfg, LocalPlannerLimits.cfg, MoveBase.cfg]
2019-03-07 Fix lidar model platform. Fix map_server. Add info for setup.
    [06-01-Платформа для лидара (front).ipt, 06-01-Платформа для лидара (rear).ipt]
2019-03-09 Fix launch, fix map for navigation, rollback odometry.
    [LedWS2812BforSTM32.h, driver.ino]
2019-03-09 Fix driver firmware (no freeze)
    [driver.ino]
2019-03-09 Rollback odometry_node.cpp (23.12.18)
2019-03-09 Add info for setup. Add stack navigation for model ankkerman.
    [TebLocalPlannerReconfigure.cfg]
2019-03-12 Fix name topic laser_scan. Add new map. Fix navigation config.
    [hlds_laser_segment_publisher.cpp]
2019-03-13 Fix teb_navigate, immo.launch, lidar frame.
    [hlds_laser_segment_publisher.cpp]
2019-03-13 Fix odometry by Chef
2019-03-14 Fix odometry problems
2019-03-14 Fix nav config, maps (poligon), frame for lidar and slam. Fix setup info.
2019-03-15 Fix odometry_node.cpp. Fix maps and params for navigation.
2019-03-19 Fix odometry
2019-03-19 Add sign reciver and detected. Fix odometry CMakeLists for correct first build.
2019-03-19 Fix lidar and led_control launch.
2019-03-20 Move by wall and correct odometry
    [driver.ino, graph_hotel.yaml, graph_profest.yaml, graph_profest2.yaml]
2020-11-18 Исправлен косяк с расчетом одометрии
    [driver.ino]
